SadButTrueUK/SolidFuelBoiler_rev2.0/README.md

Проект "Твердотопливный котёл с автоматической подачей топлива. Ревизия 2"
