SadButTrueUK/SolidFuelBoiler_rev2.0/Datasheets/blManagement-connectors.jpg

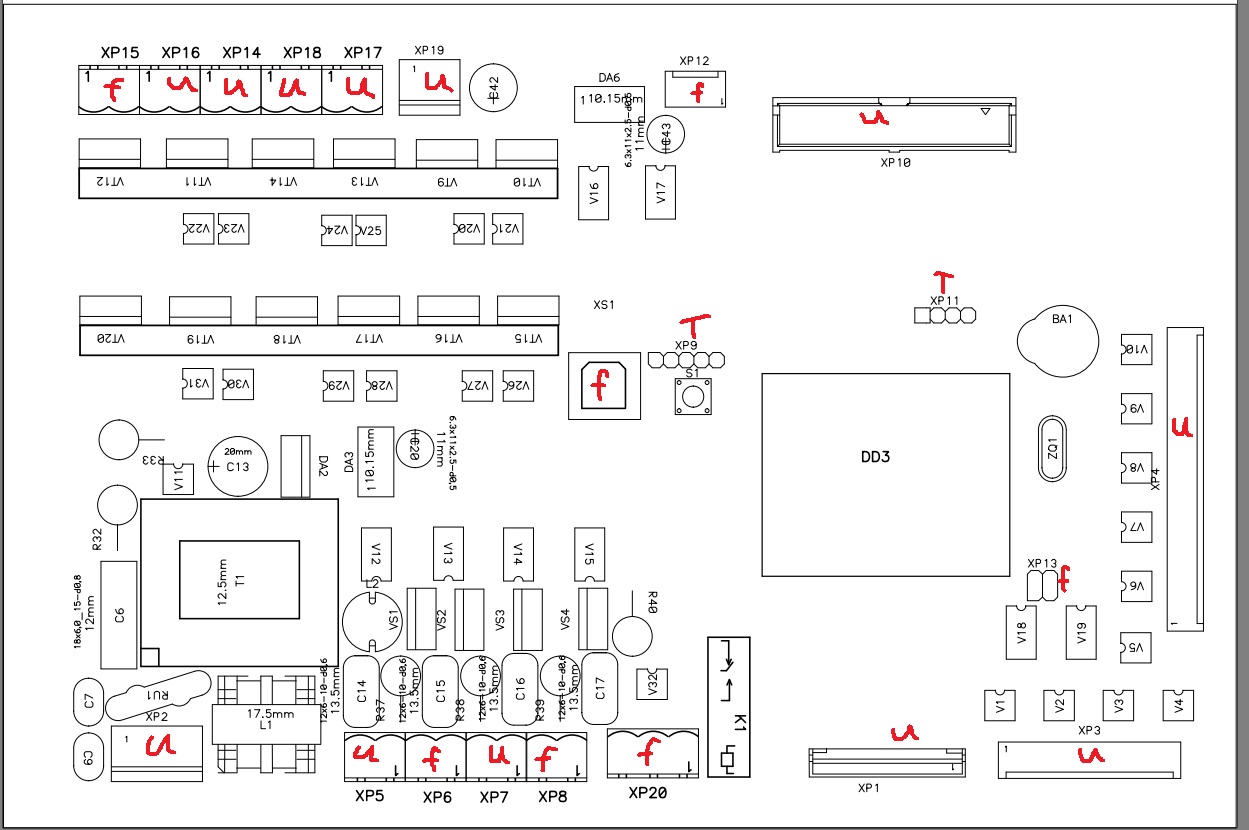
Datasheets/blManagement-connectors.jpg
