SadButTrueUK/SolidFuelBoiler_rev2.0/Datasheets/Наконечники плоские (мама).jpg

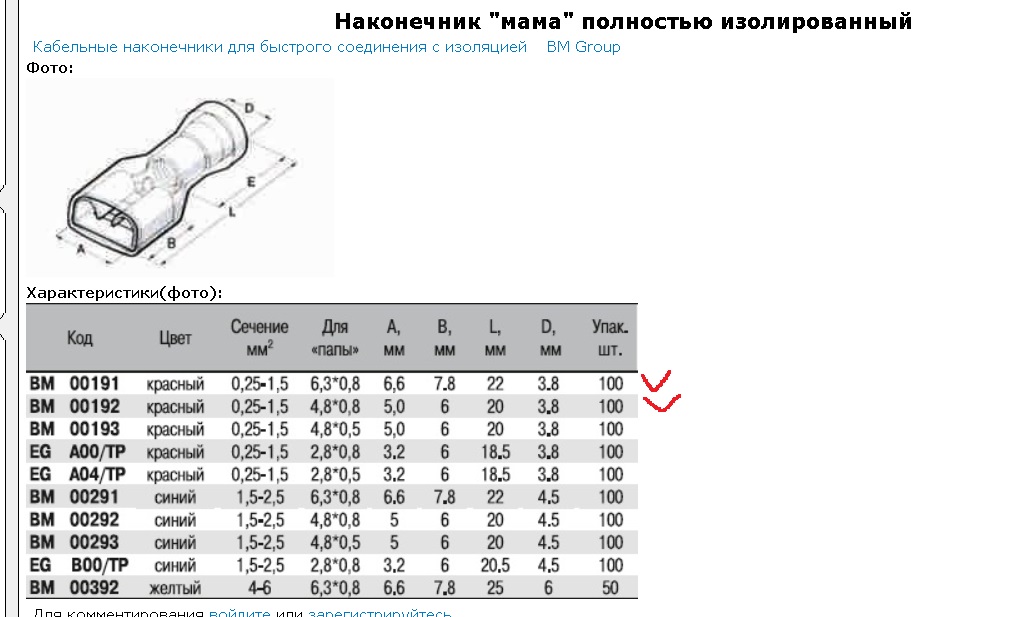
Datasheets/Наконечники плоские (мама).jpg
