SadButTrueUK/SolidFuelBoiler_rev2.0/Datasheets/Наконечники трубчатые.jpg

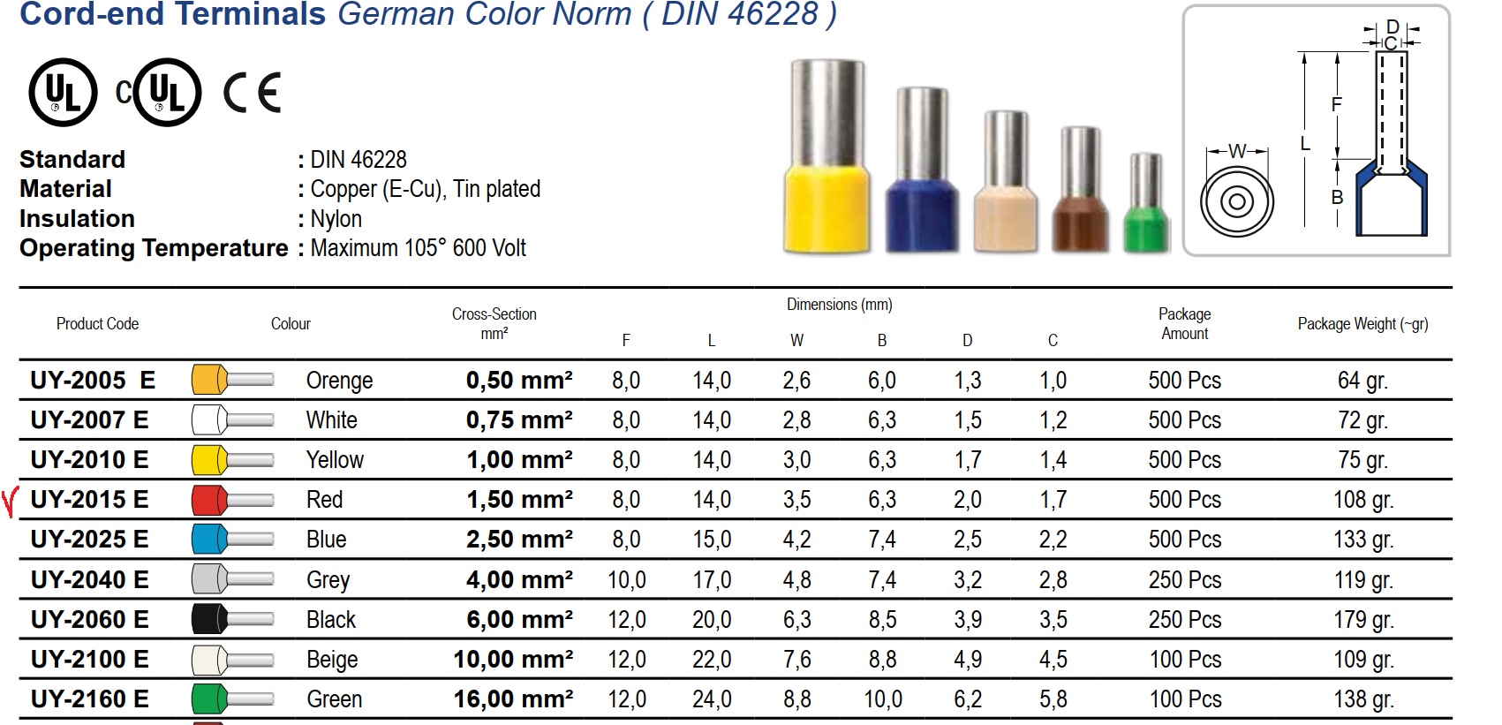
Datasheets/Наконечники трубчатые.jpg
