SadButTrueUK/SolidFuelBoiler_rev2.0/Документация/SFL rev2_0 ВП_new.xlsx

№ строки | Наименование | Поставщик | Наличие на складе | Количество, цена |  |  | Приме- чание
 |  |  |  | на из- делие | цена, шт. | цена, всего
 | Блок управления твердотопливного котла
 | Вилки
 | 2EDGV-5.08-02P-14-00AH | Космодром | ожидается 15.07 | 9 | 1.75 | 15.75
 | 2EDGV-5.08-03P | Космодром | есть | 1 | 2.75 | 2.75
 | BH-10 | Космодром | есть | 1 | 1.86 | 1.86
 | BH-26 | Космодром | есть | 1 | 2.72 | 2.72
 | NX5080-02SMS | Космодром | есть | 1 | 1.2 | 1.20
 | NX5080-03SMS | Космодром | есть | 1 | 1.91 | 1.91
 | NXW-12 | Космодром | есть | 1 | 2.25 | 2.25
 | ZL202-40G | Космодром | есть | 3 | 5.75 | 17.25 | 2x20 конт
 | ZL262-40DG | Космодром | есть | 3 | 4.25 | 12.75
 | ZL201-04G | Космодром | есть | 1 | 0.5 | 0.50
 | NS25-W4P | Космодром | есть | 1 | 2.37 | 2.37
 | NS25-W20P | Космодром | есть | 2 | 2.53 | 5.06
 |  |  |  |  |  | 0.00
 | Варисторы |  |  |  |  | 0.00
 | FNR-14K391 | Космодром | есть | 1 | 4.75 | 4.75
 |  |  |  |  |  | 0.00
 | Диоды |  |  |  |  | 0.00
 | Мост диодный B6S | Космодром | есть | 1 | 2.75 | 2.75
 | LL4148 | Космодром | есть | 3 | 0.5 | 1.50
 | SMBJ15A-TR | Космодром | есть | 1 | 3.5 | 3.50
 |  |  |  |  |  | 0.00
 | Дроссели |  |  |  |  | 0.00
 | B82432A1103K | Космодром | под заказ 20-30 дн | 1 | 13.17 | 13.17 | 10uH
 | RCH114NP-471KB | Космодром | есть | 2 | 10 | 20.00
 | MURATA PLA10AS1821R7R2B | Космодром | есть | 1 | 28.75 | 28.75
 |  |  |  |  |  | 0.00
 | Звукоизлучатель элктромагнитный HCM1203A | Космодром | есть | 1 | 10.5 | 10.50
 |  |  |  |  |  | 0.00
 | Резонаторы кварцевые |  |  |  |  | 0.00
 | HC49U-8.000MHZ-20PF | Космодром | есть | 1 | 4.75 | 4.75
 |  |  |  |  |  | 0.00
 | Кнопки |  |  |  |  | 0.00
 | КНОПКА ТАКТОВАЯ TACT-64K-F | Космодром | есть | 1 | 1.08 | 1.08 | толкатель с мин. высотой
 |  |  |  |  |  | 0.00
 | Оптроны | Космодром |  |  |  | 0.00
 | MOC3021M | Космодром |  | 2 | 9.25 | 18.50
 | MOC3063M | Космодром |  | 2 | 13 | 26.00
 | H11L1M | Космодром |  | 4 | 10.75 | 43.00
 | PC817B | Космодром |  | 25 | 1.75 | 43.75
 |  |  |  |  |  | 0.00
 | Реле |  |  |  |  | 0.00
 | РЕЛЕ FTR-F3CA012 | Космодром |  | 1 | 43 | 43.00 | подбор замены
 |  |  |  |  |  | 0.00
 | Розетки |  |  |  |  | 0.00
 | USBB-BV | Космодром | есть | 1 | 6.25 | 6.25
 | NS25-G4 | Космодром | есть | 1 |  | 0.00
 | NS25-G12 | Космодром | есть | 1 | 1 | 1.00
 | NS25-G20 | Космодром | есть | 2 | 2.5 | 5.00
 |  |  |  |  |  | 0.00
 | Симисторы |  |  |  |  | 0.00
 | BTA08-600CRG | Космодром | есть | 4 | 10.5 | 42.00
 |  |  |  |  |  | 0.00
 | Трансформаторы |  |  |  |  | 0.00
 | AS3012-E-0180-090-S | 3V3 | есть | 1 | 49.5 | 49.50
 |  |  |  |  |  | 0.00
 | Конденсаторы |  |  |  |  | 0.00
 | TECAP 10/10V A 10 | Космодром | есть | 1 | 4.75 | 4.75 | 10x10
 | Чип керамика (0805) 0,1mkf (Y5V) 50v +80-20% | Космодром | есть | 21 | 0.1 | 2.10
 | Чип керамика (0805) 22pf (NPO) 50v ± 5% | Космодром | есть | 2 | 0.1 | 0.20
 | Чип керамика (0805) 220pf (NPO) 50v ± 5% | Космодром | есть | 3 | 0.1 | 0.30
 | Чип керамика (0805) 1000pf (X7R) 50v ± 10% | Космодром | есть | 2 | 0.1 | 0.20
 | Чип керамика (0805) 3300pf (X7R) 50v ± 10% | Космодром | есть | 1 | 0.1 | 0.10
 | 2200 pf (250 VAC) 20% КЕРАМИЧЕСКИЕ (Class Y2) | Космодром | есть | 2 | 1.5 | 3.00
 | ECAP-KM-1000mkf - 25v Электролит | Космодром | есть | 1 | 3.5 | 3.50
 | ECAP-RD-220mkf - 16v Электролит | Космодром | есть | 2 | 1 | 2.00
 | ECAP-RD-470mkf - 16v Электролит | Космодром | есть | 1 | 1.75 | 1.75
 | (CL-21) 0,1mkf - 630v (±10%) Металлоплёнка | Космодром | есть | 4 | 1.37 | 5.48
 | (CLASS X1) 0,1mkf-300 VAC (±10%) P:15mm | Космодром | есть | 1 | 2.5 | 2.50
 |  |  |  |  |  | 0.00
 | Микросхемы |  |  |  |  | 0.00
 | 74HC164D.653 | Космодром | есть | 1 | 4.5 | 4.50
 | AD8542ARZ-REEL7 | Космодром | есть | 1 | 22 | 22.00
 | ADUM1210BRZ | Космодром | есть | 1 | 82.75 | 82.75
 | 24LC08BT-I/SN | Космодром | есть | 1 | 12.25 | 12.25
 | LM1117IMP-3.3/NOPB | Космодром | есть | 2 | 25.25 | 50.50
 | L7805CV | Космодром | есть | 1 | 4.75 | 4.75
 | B0512S-1W | Космодром | есть | 1 | 59.75 | 59.75
 | B1205S-1W | Космодром | есть | 1 | 53.75 | 53.75
 | PIC18F87J50-I/PT | Космодром | есть | 1 | 95.5 | 95.50
 | SN65HVD10D | Космодром | есть | 1 | 60.75 | 60.75
 | TL431BQDBZR.215 | Космодром | есть | 1 | 7.25 | 7.25
 |  |  |  |  |  | 0.00
 |  |  |  |  |  | 0.00
 | Резисторы |  |  |  |  | 0.00
 | C2-23-1-51 Ом±5% | Космодром | нет | 4 | 0.7 | 2.80
 | C2-23-1-510 кОм±5% | Космодром | нет | 2 | 0.7 | 1.40
 | SMD-резистор (0805) 100 Om ±1% (точные) | Космодром | есть | 1 | 0.1 | 0.10
 | SMD-резистор (0805) 330 Om ±5% | Космодром | есть | 12 | 0.1 | 1.20
 | SMD-резистор (0805) 680 Om ±5% | Космодром | есть | 8 | 0.1 | 0.80
 | SMD-резистор (0805) 1 kOm ±5% | Космодром | есть | 31 | 0.1 | 3.10
 | SMD-резистор (0805) 2 kOm ±5% | Космодром | есть | 21 | 0.1 | 2.10
 | SMD-резистор (0805) 3.3 kOm ±5% | Космодром | есть | 14 | 0.1 | 1.40
 | SMD-резистор (0805) 4,7 kOm ±1% (точные) | Космодром | есть | 5 | 0.1 | 0.50
 | SMD-резистор (0805) 6.8 kOm ±5% | Космодром | есть | 2 | 0.1 | 0.20
 | SMD-резистор (0805) 10 kOm ±1% (точные) | Космодром | есть | 7 | 0.1 | 0.70
 | SMD-резистор (0805) 15 kOm ±1% (точные) | Космодром | есть | 1 | 0.1 | 0.10
 | SMD-резистор (0805) 30 kOm ±1% (точные) | Космодром | есть | 2 | 0.1 | 0.20
 | SMD-резистор (0805) 150 kOm ±1% (точные) | Космодром | есть | 1 | 0.1 | 0.10
 | SMD-резистор (0805) 470 kOm ±5% | Космодром | есть | 1 | 0.1 | 0.10
 | SMD-резистор (1206) 5.6 Om ±5% | Космодром | есть | 2 | 0.1 | 0.20
 | SMD-резистор (1206) 470 Om ±5% | Космодром | есть | 12 | 0.1 | 1.20
 |  |  |  |  |  | 0.00
 | Транзисторы |  |  |  |  | 0.00
 | IRF3710PBF | Космодром | есть | 6 | 14 | 84.00
 | IRF5305PBF | Космодром | есть | 6 | 14.5 | 87.00
 | BC807-40 | Космодром | есть | 1 | 1 | 1.00
 | BC847С | Космодром | есть | 9 | 1.25 | 11.25
 | Блок индикации твердотопливного котла
 | Индикаторы, светодиоды
 | Индикатор семисегментный E30561-I-O-8-W | Космодром | есть | 2 | 10.5 | 21.00
 | Светодиод FYL-3004GD (зелёный, матовый, d=3мм) | Космодром | есть | 2 | 2.75 | 5.50
 | Светодиод FYL-3015EGW-3PIN (d=3мм, красный/зеленый) | Космодром | есть | 1 | 7.82 | 7.82
 |  |  |  |  |  | 0.00
 | Кнопки |  |  |  |  | 0.00
 | Кнопка тактовая TACTS-24N-F | Космодром | ожидается 31.07 | 3 | 1.75 | 5.25
 | Колпачок для кнопки SWT-9R-G | Космодром | есть | 4 | 0.5 | 2.00
 |  |  |  |  |  | 0.00
 | Соединители |  |  |  |  | 0.00
 | Вилка FDC-26 | Космодром | есть | 1 | 4 | 4.00
 | Прочее
 | Плата адаптера MAKET-PCB-QFP32-100-0.5-0.8 | Космодром | есть | 2 | 14.75 | 29.50
 | Плата блока управления |  |  | 1 | ??? |  | узнать цены
 | Плата блока индикации |  |  | 1 | ??? |  | узнать цены
 | Шлейф плоский с шагом 1,27мм FLC-26 | Космодром | есть | 1 | 23 | 23.00 | 1м
 | Радиатор ребристый алюминиевый ALPR-030X72 | Космодром |  | 2 | 15.75 | 31.50
 | Итого, грн |  |  |  |  | 1243.77
