SadButTrueUK/SolidFuelBoiler_rev2.0/PDF/BlockManagementSFB_schematic.pdf

## Debug SPI

## Ash cleaning

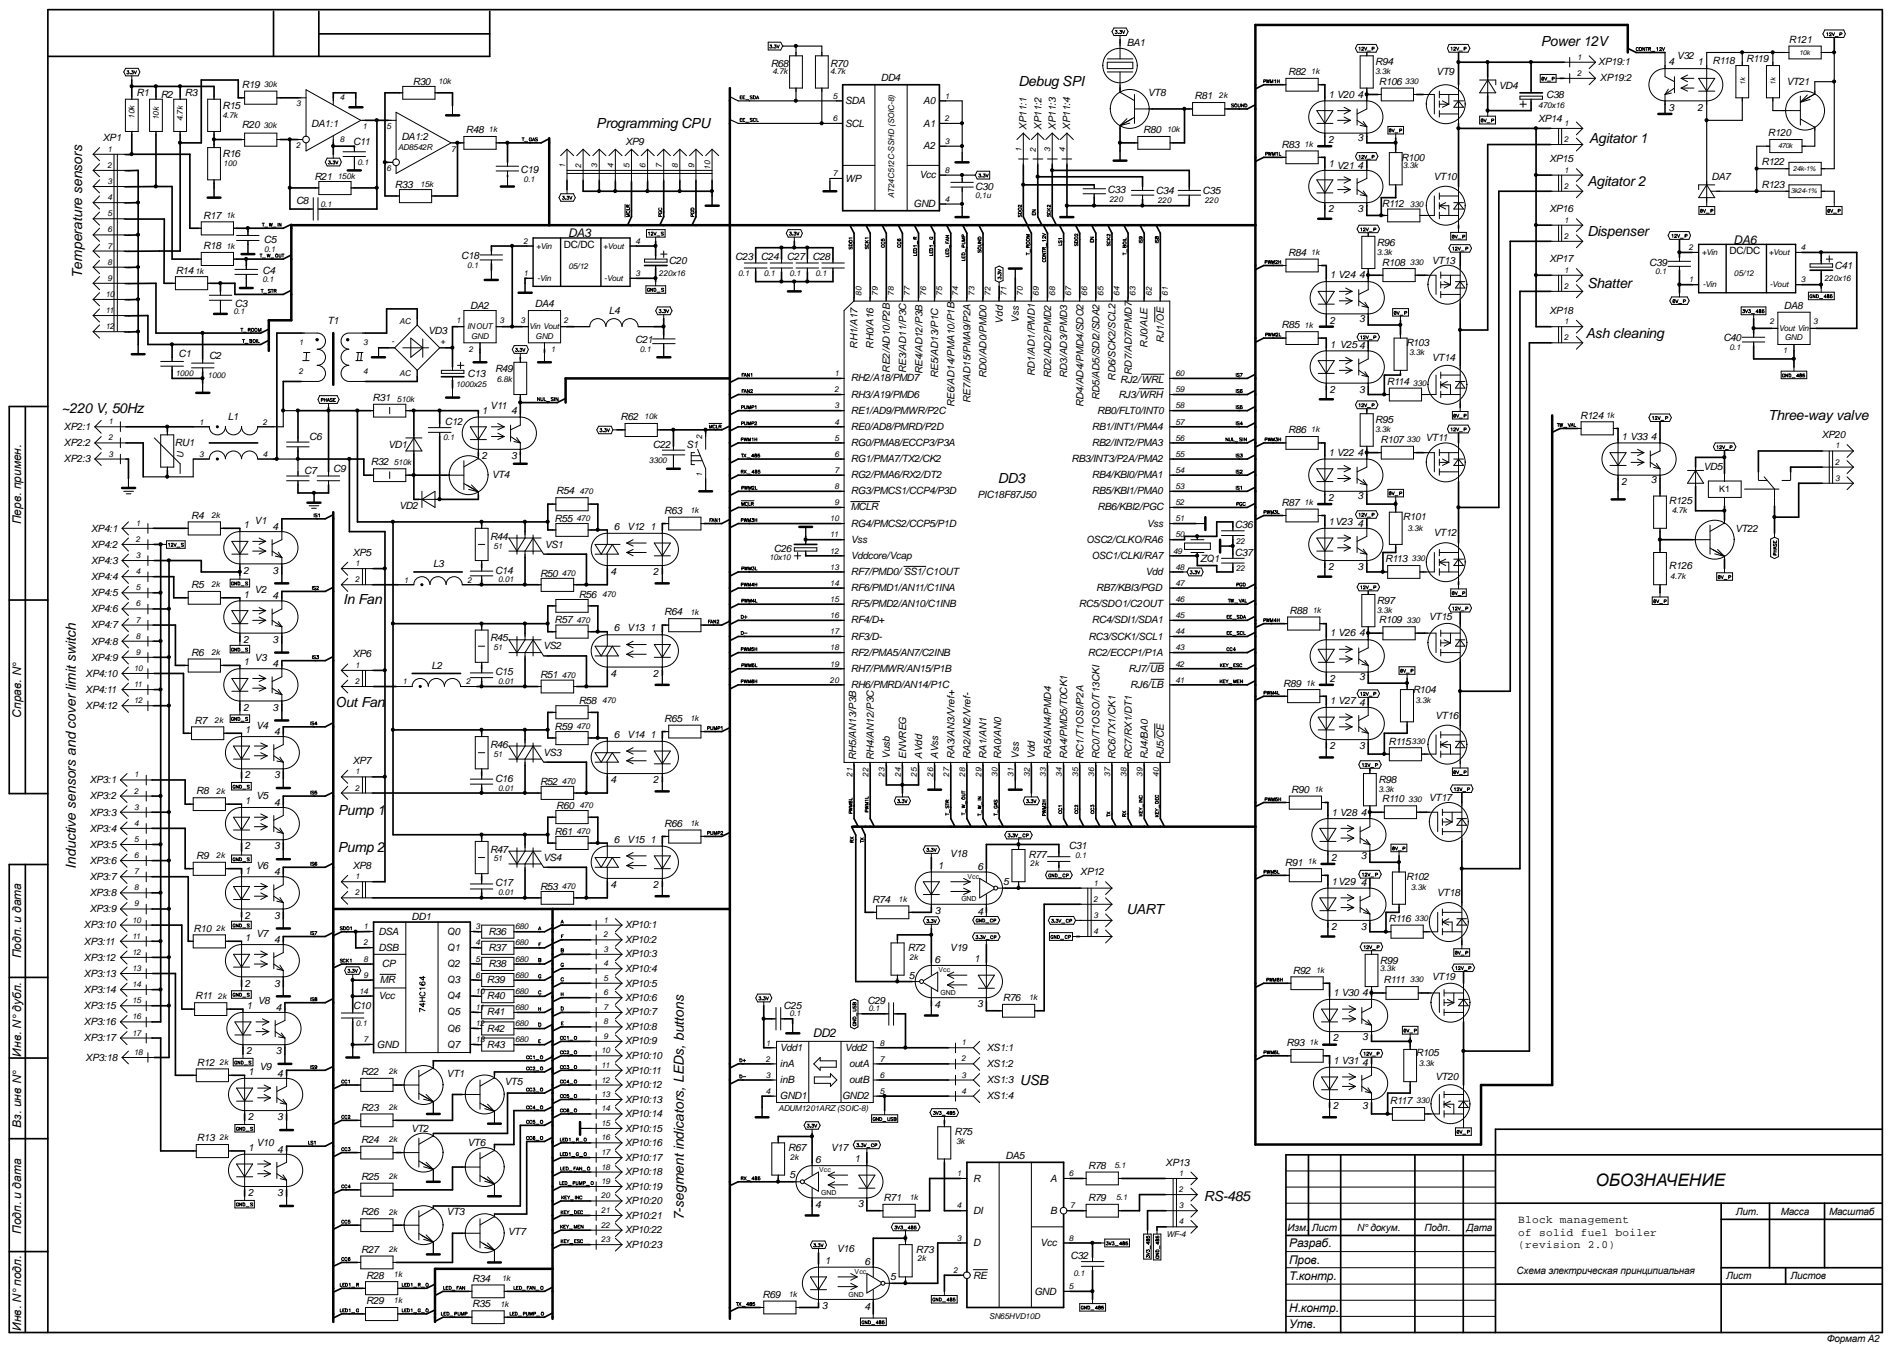
[picture p4: page 1]

ОБОЗНАЧЕНИЕ

Block management of solid fuel boiler (revision 2.0) Схема электрическая принципиальная | Лит. | Масса | Масштаб

Изм. Лист | N° докум. | Подп. | Дата
Разраб.
Пров.

Н.контр.
Утв.
