SadButTrueUK/SolidFuelBoiler_rev2.0/PCAD/SFL 2_0-all.pdf

2 | Вентилятор к.2 XS18 | FU1

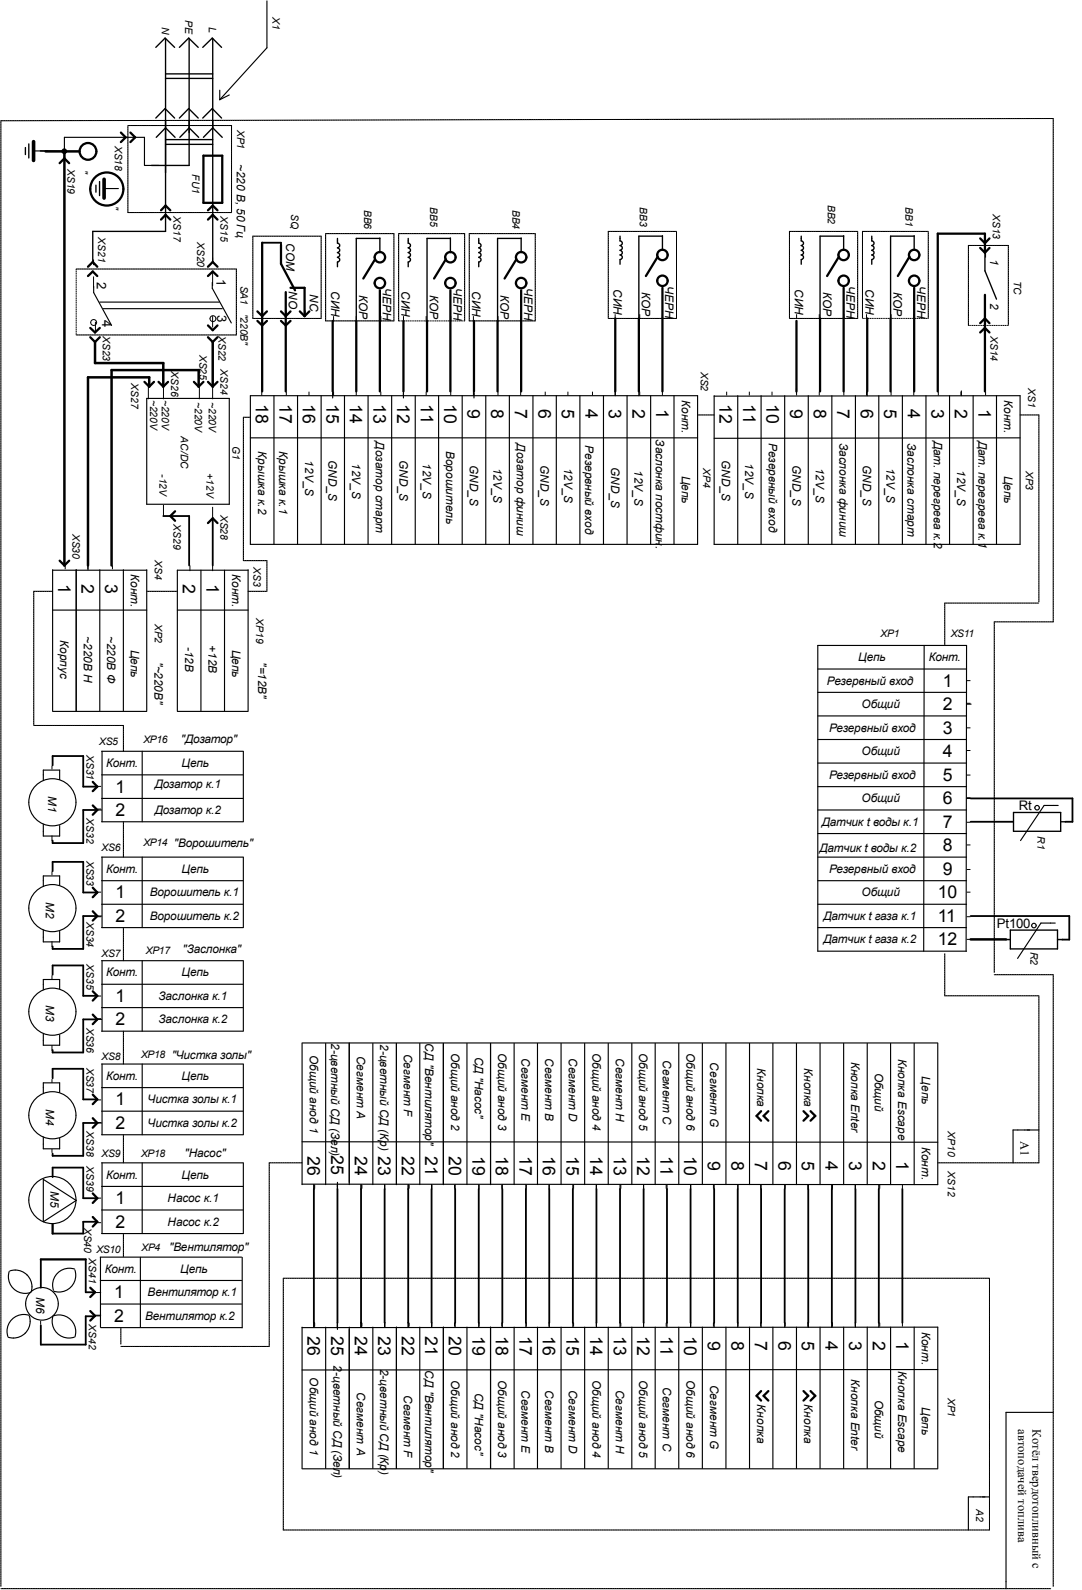
[picture p5: page 1]
Дозатор к.1; Резервный вход; Дозатор к.2; Датчик t воды к.2; Общий; Датчик t газа к.1; "Дозатор"; Ворошитель к.1; Ворошитель к.2; "Вентилятор"; СИН; ЧЕРН; Конт.; Корпус; Цепь; Конт. Цепь; Общий анод 1; Сегмент F; Общий анод 2; СД "Насос"; Сегмент E; Сегмент B; Общий анод 4; Сегмент H; Сегмент C; Кнопка; КОР; Цепь⁺¹²В; Датчик t газа к.2; "Насос"; Сегмент A; Общий анод 3; СД "Вентилятор"; Общий анод 5; Сегмент D; Сегмент G; Общий анод 6; Кнопка Escape; Кнопка Enter; "Ворошитель"; "Заслонка"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

COM NO SQ

Цепь | Конт.

Резервный вход

Общий | 2

Резервный вход | 3

Общий | 4

Общий | 6

Датчик t воды к.1 | 7

Конт. | Цепь
1 | Заслонка к.1
2 | Заслонка к.2

2-цветный СД (Зел)

2-цветный СД (Кр)

1 | Чистка золы к.1
2 | Чистка золы к.2

1 | Насос к.1

2 | Насос к.2

1 | Вентилятор к.1
