SadButTrueUK/SolidFuelBoiler_rev2.0/(list of files, drawings)

Other design files:
PCAD/block_ind_rev2_0.pcb
PCAD/sfl_rev_2_0.pcb
Инструкции/front panel.PCB
Инструкции/screens.pcb
