SadButTrueUK/SolidFuelBoiler_rev2.0/Backup_software/25_12_19/src/Module_management/module_management.h

#ifndef _MODULE_MANAGEMENT_H_
#define _MODULE_MANAGEMENT_H_

#include "stdint.h"

#define QUANTITY_MOTORS 			4
#define QUANTITY_OF_FUEL_TYPE		3
#define SIZE_BUFFER     			53
#define IS_FAILURE 					1
#define NO_FAILURE 					0U

/* Значения автомата состояний модуля управления  */
#define STATE_WAITING				0U
#define STATE_FUEL_SUPPLY			1U
#define STATE_BURNING				2U
#define STATE_PAUSE					3U
#define STATE_CLEAN_CHIMNEY			4U
#define STATE_FAILURE				5U

#define IS_DRAUGHT                  1
#define NO_DRAUGHT                  0

/*Коды ошибок */
#define CODE_FAILURE_IS_NO_FAILURE							0U
#define CODE_FAILURE_BREAK_T_GAS_SENSOR                     1U
#define CODE_FAILURE_SHORT_CIRCUIT_T_GAS_SENSOR             2U
#define CODE_FAILURE_BREAK_T_WATER_SENSOR					3U
#define CODE_FAILURE_SHORT_CIRCUIT_T_WATER_SENSOR			4U
#define CODE_FAILURE_MOTOR_LS_DISPENSER_START				5U
#define CODE_FAILURE_MOTOR_LS_DISPENSER_FINISH				6U
#define CODE_FAILURE_MOTOR_LS_SHATTER_START                 7U
#define CODE_FAILURE_MOTOR_LS_SHATTER_FINISH				8U
#define CODE_FAILURE_MOTOR_LS_AFTER_SHATTER_FINISH			9U

#define CODE_FAILURE_MOTOR_LS_DISPENSER_START_FALSE_ON			10U
#define CODE_FAILURE_MOTOR_LS_DISPENSER_FINISH_FALSE_ON			11U
#define CODE_FAILURE_MOTOR_LS_SHATTER_START_FALSE_ON			12U
#define CODE_FAILURE_MOTOR_LS_SHATTER_FINISH_FALSE_ON			13U
#define CODE_FAILURE_MOTOR_LS_AFTER_SHATTER_FINISH_FALSE_ON		14U

#define CODE_FAILURE_MOTOR_LS_AGITATOR							15U
#define CODE_FAILURE_DRAUGHT									16U
#define CODE_FAILURE_NO_220V									17U

/*Фазы работы алгоритма в состоянии горения */
#define CALC_PARAMS_PERIOD				0U
#define START_BURNING					1U
#define INCREASE_TEMPERATURE			2U
#define ECONOM_MODE                     3U
#define MAINTENANCE_TEMPERATURE_CYCLE	4U
#define MAINTENANCE_TEMPERATURE_INCR	5U
 
/* убрать */
#define MAINTENANCE_TEMPERATURE     5U
#define BURNING_OFF					6U


#define LOW_THRESHOLD_IN_BURNING_TEMPER_GAS             6U   //пороговое значение температуры газа (60 градусов), 
																	 //ниже которого делаем переход на аварию тяги
#define TIMEOUT_CHECK_FAILURE_DRAUGHT					6000U 		//600 секунд (10 минут)	
#define TIMEOUT_CHECK_CHANGE_TEMPERATURE_WATER          18000U   //30 минут


/*Индексы массива двигателей */
#define INDEX_OF_DISPENSER			0
#define INDEX_OF_AGITATOR			1
#define INDEX_OF_SHATTER			2

//to do Пересмотреть все индексы
#define INDEX_OF_CODE_FAILURE							50
#define INDEX_OF_TEMPER_SETUP							39
#define INDEX_OF_LEVEL_FAN_ROTATION_SPEED_MAINTENANCE	16
#define INDEX_OF_LEVEL_FAN_ROTATION_SPEED_INCREASE		47

#define TEMPERATURE_DECREASED				1
#define TEMPERATURE_INCREASED_OR_EQUAL		0
#define NUMBER_OF_FUEL_TYPE	3

#define PAUSE_IN_CYCLE	0
#define WORK_IN_CYCLE	1

typedef struct 
{
	uint8_t  time_accel;   				//время разгона двигателя в 1/100 с. Диапазон значений 10...100 (100мс...1с)
	uint8_t  max_time_work;			//максимальное время вращения двигателя в с. Диапазон значений 1...60 (1с...60с)  
	uint8_t  min_PWM_accel; 			//минимальный процент скважности ШИМа при разгоне двигателя. Диапазон значений 28...100 
	uint8_t  quantity_repeat_try;   		//количество повторных попыток вращения двигателя при несрабатывании концевика, 
									//после которого появляется признак аварии
}Motor_t;

typedef struct 
{
	uint8_t min_turn_percent;									//минимальный процент скорости оборотов вентилятора. Диапазон значений 2...4 
	uint8_t max_turn_percent;									//максимальный процент скорости оборотов вентилятора. Диапазон значений 4...8. Зависит от диаметра дымохода
	uint8_t time_work_in_cycle[NUMBER_OF_FUEL_TYPE];			//время работы вентилятора в цикле работа-пауза в секундах. Диапазон значений 5...120
	uint8_t time_pause_in_cycle[NUMBER_OF_FUEL_TYPE];			//время простоя вентилятора в цикле работа-пауза в десятках секунд. 
                                                                //Диапазон значений 12...360 (2 - 60 минут)
	uint8_t delta_from_cycle_to_heat[NUMBER_OF_FUEL_TYPE];		//разница между текущей и установленной температурами (2...5), при которой отключается режим 
                                                                //работа-пауза (при остывании котла)
	uint8_t time_accel_fan[NUMBER_OF_FUEL_TYPE];				//время разгона вентилятора от мин до макс оборотов при входе в режим горения в десятках секунд от 12 до 30
	uint8_t delta_temper_for_econom_mode[NUMBER_OF_FUEL_TYPE];  //разница между установленной и текущей температурой, по которой 
                                                                // вентилятор переходит на минимальные обороты (для экономного сжигания топлива)
	uint8_t level_fan_in_econom_mode[NUMBER_OF_FUEL_TYPE];		// уровень оборотов вентилятора в переходе на эконом-режим от 2 до 4
	uint8_t level_fan_in_smoldering[NUMBER_OF_FUEL_TYPE];		// уровень оборотов вентилятора в режиме продувки/тления от 2 до 4
}Fan_t;

typedef struct 
{
	Motor_t Motor[QUANTITY_MOTORS]; 	//массив структур двигателей (дозатор, ворошитель, заслонка)
	Fan_t   Fan; 					  		  	//структура вентилятора
	uint8_t temper_setup;				  		//установленная температура
	uint8_t fuel_type;					  		//тип топлива
	uint8_t enable_sound;				  		//флаг разрешения звука. 1 - разрешён, 0 - запрещён
	uint8_t time_auto_exit;	  			  		//время в секундах по истечении которого, если нет действий пользователя, выходим из меню
	uint8_t period_load_fuel_in_heat[QUANTITY_OF_FUEL_TYPE];   //период загрузок топлива в режиме нагрева в зависимости от каждого вида топлива
	uint8_t delta_temper_threshold;				//пороговое значение разницы между текущей и установленной температурой, 
                                                //по которой управляется вентилятор
	uint8_t rotational_speed_fan;		  		//уровень оборотов вращения вентилятора в рабочем режиме
	uint8_t time_work_ashCleaner;               //время работы двигателя чистки золы (в секундах)
    uint8_t period_work_ashCleaner;             //период между включениями двигателя чистки золы (в сотнях секунд)
    uint8_t code_failure;	  			     	//код  аварии
	uint8_t last_state;	  				  		//код текущего состояния в автомате состояний
	uint8_t software_version;			  		//версия программного обеспечения МК. Начинается с 1.00
    
}MENU_PARAMETERS; 

typedef union 
{
	MENU_PARAMETERS menu_parameters;
	uint8_t buffer[SIZE_BUFFER]; 
}ParametersBuffer;

ParametersBuffer*  M_Mngm_Get_parameters_buffer(void);
uint8_t             M_Mngm_Get_state(void);
uint8_t             M_Mngm_Get_Code_Failure(void);
uint8_t             M_Mngm_Check_Failure(void);
uint8_t             M_Mngm_Get_previous_state(void);
uint8_t             M_Mngm_get_burning_state(void);
void                M_Mngm_Run (void);
void                M_Mngm_waiting(void);
void                M_Mngm_fuel_supply(void);
void                M_Mngm_burning(void);
void                M_Mngm_pause(void);
void                M_Mngm_clean_chimney(void);
void                M_Mngm_failure(void);
void                M_Mngm_Set_state(uint8_t value);
void                M_Mngm_need_to_pause(const uint8_t prev_state);
void                M_Mngm_Set_Code_Failure(uint8_t value);
void                M_Mngm_clear_timeouts(void);
void                M_Mngm_set_saved_temperature_water(uint8_t value);
void                M_Mngm_check_draught_failure(void);
BOOL                M_Mngm_check_change_temperature_water(void);
void                M_Mngm_Set_state_draught(BOOL value);
BOOL    			M_Mngm_accel_fan(void);
BOOL 				M_Mngm_cyclic_mode(void);
void 				M_Mngm_clear_accel_fan(void);
void 				M_Mngm_clear_cyclic_mode(void);
BOOL 				M_Mngm_get_phase_cycle(void);
uint8_t* 			M_Mngm_get_pFanLevel(void);
uint8_t 			M_Mngm_get_fanParamOffset(void);
void 				M_Mngm_set_burning_state(uint8_t value);


#endif
