SadButTrueUK/SolidFuelBoiler_rev2.0/Backup_software/25_12_19/src/Main/boardModes.h

#ifndef _BOARD_MODES_H_
#define _BOARD_MODES_H_

//Тип 7-сегментного индикатора на плате индикации
//#define BOARD_INDICATION_COMMON_CATHODE
#define BOARD_INDICATION_COMMON_ANODE

#define ENABLE_PULLUPS_ON_PORTB_AND_PORTJ

//Разрешение работы второго насоса (для ГВС)
//#define ENABLE_SECOND_PUMP

//Разрешение работы трёхходового клапана
//#define ENABLE_TRISTATE_VALVE 

//#define ENABLE_ASH_CLEANER_INDUCIVE_SENSORS


#endif  // _BOARD_MODES_H_
