SadButTrueUK/SolidFuelBoiler_rev2.0/Backup_software/26_04_20/src/EEPROMmemory/crc8.h

/*
 * Library: libcrc
 * File:    include/checksum.h
 * Author:  Lammert Bies
 *
 * This file is licensed under the MIT License as stated below
 *
 * Copyright (c) 1999-2018 Lammert Bies
 *
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
 * Description
 * -----------
 * The headerfile include/checksum.h contains the definitions and prototypes
 * for routines that can be used to calculate several kinds of checksums.
 */

//*****************************************************************************
// Команды препроцессора для предотвращения повторного включения содержимого файла
//*****************************************************************************
#ifndef CRC8_H
#define CRC8_H

//*****************************************************************************
// Подключаемые файлы
//*****************************************************************************
#include <stdint.h>

//*****************************************************************************
// Прототипы интерфейсных функций
//*****************************************************************************

//*****************************************************************************
/// \brief Вычисление контрольной суммы.
/// \param crc  - начальное значение CRC8;
/// \param data - указатель на массив данных;
/// \param len  - длина массива данных.
/// \return Значение контрольной суммы.
/// \note В качестве алгоритма вычисления контрольной суммы
/// используется CRC8, с начальным значением crc и полиномом \f$x^8 + x^7 + x^2 + 1\f$.
///
uint8_t crc8_update( uint8_t crc, const uint8_t *data, uint8_t len );

#endif 
